MrOnak/avr_usbhid_gamepanel/board/board_commented.jpg

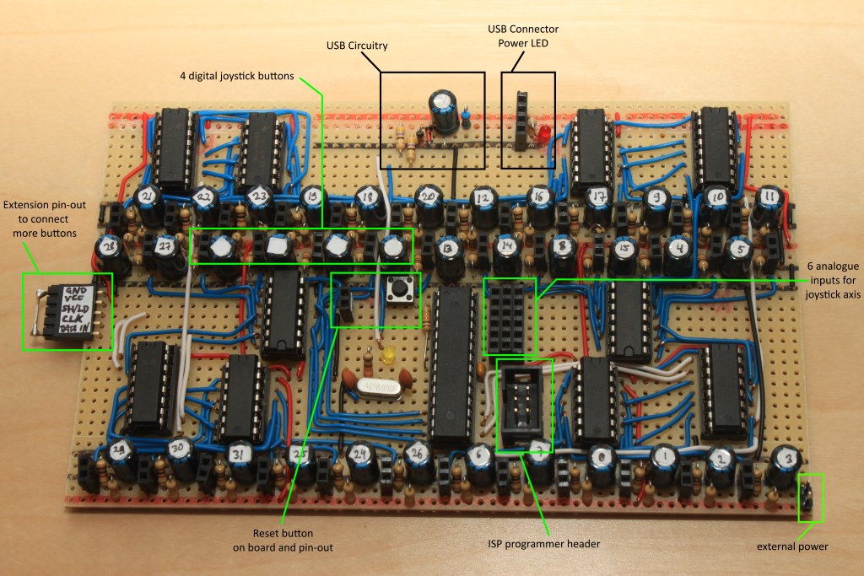
board/board_commented.jpg
