MrOnak/avr_usbhid_gamepanel/eagle/avr_gamepanel.png

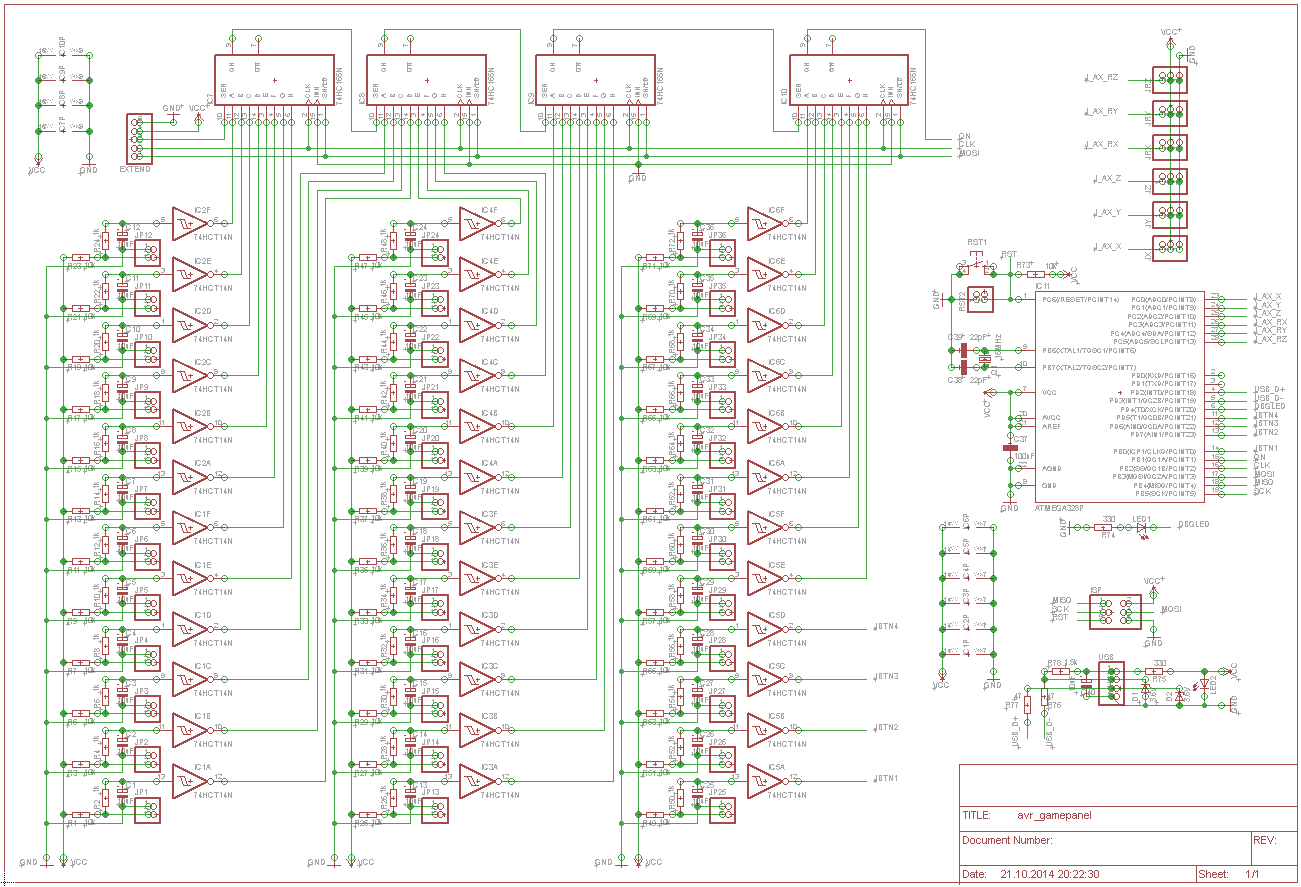
eagle/avr_gamepanel.png
