MrOnak/avr_usbhid_gamepanel/(threads)

Thread 2 (2016-04-25):

Additional usbSetInterrupt()

steinm, 2016-04-25:
While having problems with specifying a hid device consisting of a keyboard and a mouse I found your code and discovered the same problem I have. The device cannot be registered for some reason. You fixed it by adding
```
/**
 * no idea why I need to send this byte	but if I don't,
 * the OS won't register the device.
 */
 while (!usbInterruptIsReady()) {usbPoll();}
 usbSetInterrupt(0x00, 1);
```
That sends another 1 byte data packet and I really wonder why it solves your problem. It didn't help in my case. When I started to anaylse the usb signals I found out that the keyboard data was requested by the host, but was never send by the device. The reason is quite simple. A data packet may not have more than 8 Bytes in low speed operation, but the device tries to send 9 Bytes, because it also sends the report id. Reducing the keycode from 6 to 5 Bytes solved the problem.

hexagon5un, 2016-05-11:
Aha!  And that shouldn't really cause any problems most of the time either.  That's great.
