MrOnak/avr_usbhid_gamepanel/eagle/avr_gamepanel.sch

## EAGLE design eagle/avr_gamepanel.sch (2014-10-21)

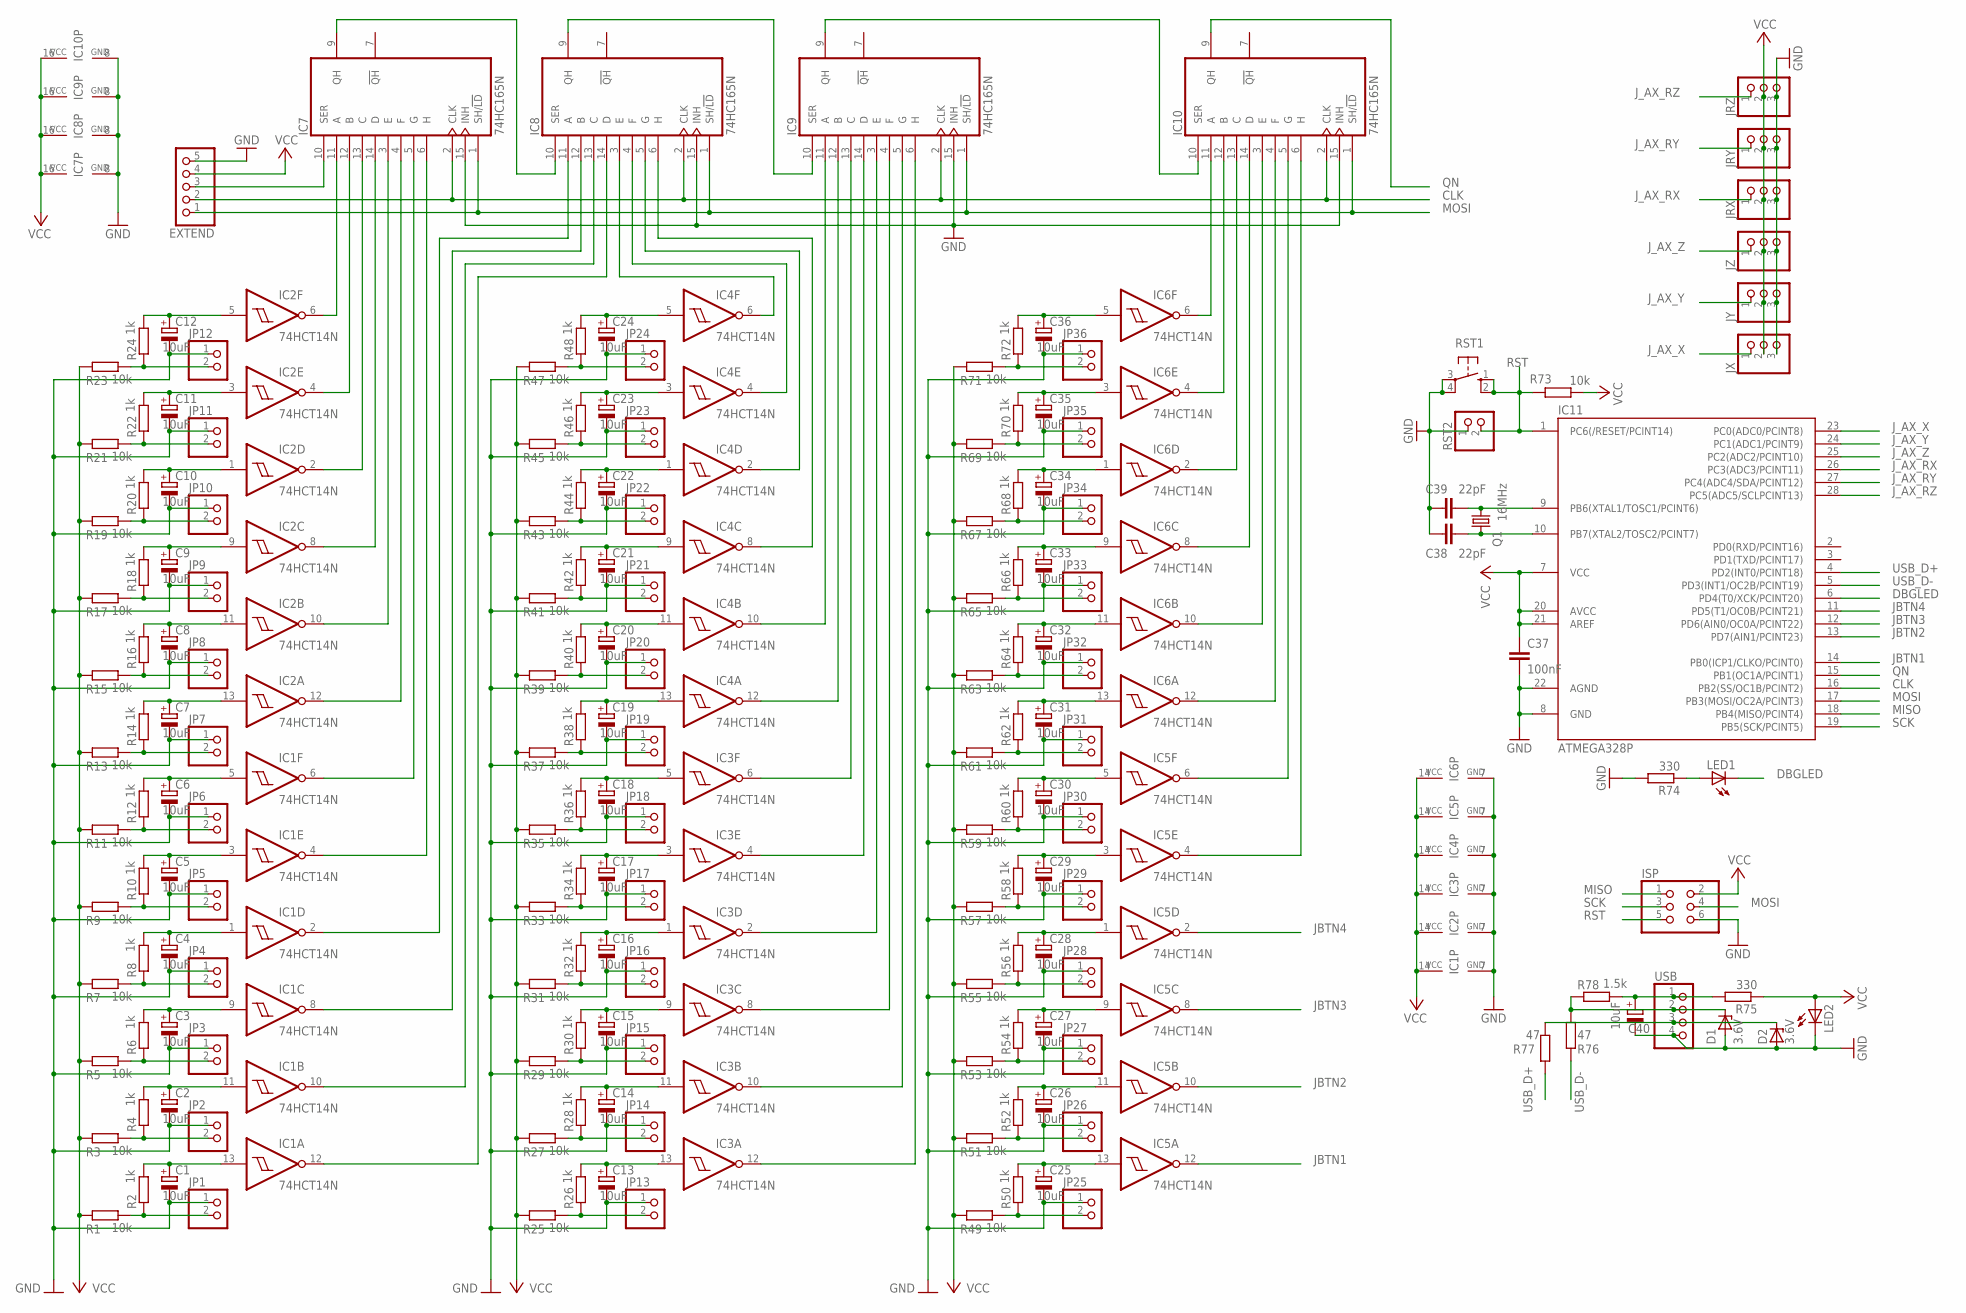
[picture p3: schematic avr_gamepanel.sch]

Parts:
C1, C2, C3, C4, C5, C6, C7, C8, C9, C10, C11, C12, C13, C14, C15, C16, C17, C18, C19, C20, C21, C22, C23, C24, C25, C26, C27, C28, C29, C30, C31, C32, C33, C34, C35, C36: 10uF; E2-5
C37: 100nF; C025-024X044
C38, C39: 22pF; C025-024X044
C40: 10uF; E2,5-6E
D1, D2: 3.6V; ZDIO-2.5
EXTEND: PINHD-1X5; 1X05
IC1, IC2, IC3, IC4, IC5, IC6: 74HCT14N; DIL14
IC7, IC8, IC9, IC10: 74HC165N; DIL16
IC11: ATMEGA328P; DIL28-3
ISP: PINHD-2X3; 2X03
JP1, JP2, JP3, JP4, JP5, JP6, JP7, JP8, JP9, JP10, JP11, JP12, JP13, JP14, JP15, JP16, JP17, JP18, JP19, JP20, JP21, JP22, JP23, JP24, JP25, JP26, JP27, JP28, JP29, JP30, JP31, JP32, JP33, JP34, JP35, JP36: PINHD-1X2; 1X02
JRX: PINHD-1X3; 1X03
JRY: PINHD-1X3; 1X03
JRZ: PINHD-1X3; 1X03
JX: PINHD-1X3; 1X03
JY: PINHD-1X3; 1X03
JZ: PINHD-1X3; 1X03
LED1, LED2: LEDLZR181; LZR181
Q1: 16MHz; HC49/S
R1, R3, R5, R7, R9, R11, R13, R15, R17, R19, R21, R23, R25, R27, R29, R31, R33, R35, R37, R39, R41, R43, R45, R47, R49, R51, R53, R55, R57, R59, R61, R63, R65, R67, R69, R71: 10k; 0204V
R2, R4, R6, R8, R10, R12, R14, R16, R18, R20, R22, R24, R26, R28, R30, R32, R34, R36, R38, R40, R42, R44, R46, R48, R50, R52, R54, R56, R58, R60, R62, R64, R66, R68, R70, R72: 1k; 0204/5
R73: 10k; 0204/7
R74, R75: 330; 0204/7
R76, R77: 47; 0204/7
R78: 1.5k; 0204/7
RST1: 10-XX; B3F-10XX
RST2: PINHD-1X2; 1X02
USB: PINHD-1X4; 1X04

Connections:
CLK: EXTEND.2, IC7.2 (CLK), IC8.2 (CLK), IC9.2 (CLK), IC10.2 (CLK), IC11.16 (PB2(SS/OC1B/PCINT2))
DBGLED: IC11.6 (PD4(T0/XCK/PCINT20)), LED1.K (C)
GND: C1.-, C2.-, C3.-, C4.-, C5.-, C6.-, C7.-, C8.-, C9.-, C10.-, C11.-, C12.-, C13.-, C14.-, C15.-, C16.-, C17.-, C18.-, C19.-, C20.-, C21.-, C22.-, C23.-, C24.-, C25.-, C26.-, C27.-, C28.-, C29.-, C30.-, C31.-, C32.-, C33.-, C34.-, C35.-, C36.-, C37.2, C38.1, C39.1, C40.-, D1.A, D2.A, EXTEND.5, IC1.7 (GND), IC2.7 (GND), IC3.7 (GND), IC4.7 (GND), IC5.7 (GND), IC6.7 (GND), IC7.8 (GND), IC7.15 (INH), IC8.8 (GND), IC8.15 (INH), IC9.8 (GND), IC9.15 (INH), IC10.8 (GND), IC10.15 (INH), IC11.8 (GND), IC11.22 (AGND), ISP.6, JP1.1, JP2.1, JP3.1, JP4.1, JP5.1, JP6.1, JP7.1, JP8.1, JP9.1, JP10.1, JP11.1, JP12.1, JP13.1, JP14.1, JP15.1, JP16.1, JP17.1, JP18.1, JP19.1, JP20.1, JP21.1, JP22.1, JP23.1, JP24.1, JP25.1, JP26.1, JP27.1, JP28.1, JP29.1, JP30.1, JP31.1, JP32.1, JP33.1, JP34.1, JP35.1, JP36.1, JRX.3, JRY.3, JRZ.3, JX.3, JY.3, JZ.3, LED2.K (C), R74.2, RST1.3, RST1.4 (P1), RST2.1, USB.4
JBTN1: IC5.12 (O), IC11.14 (PB0(ICP1/CLKO/PCINT0))
JBTN2: IC5.10 (O), IC11.13 (PD7(AIN1/PCINT23))
JBTN3: IC5.8 (O), IC11.12 (PD6(AIN0/OC0A/PCINT22))
JBTN4: IC5.2 (O), IC11.11 (PD5(T1/OC0B/PCINT21))
J_AX_RX: IC11.26 (PC3(ADC3/PCINT11)), JRX.1
J_AX_RY: IC11.27 (PC4(ADC4/SDA/PCINT12)), JRY.1
J_AX_RZ: IC11.28 (PC5(ADC5/SCLPCINT13)), JRZ.1
J_AX_X: IC11.23 (PC0(ADC0/PCINT8)), JX.1
J_AX_Y: IC11.24 (PC1(ADC1/PCINT9)), JY.1
J_AX_Z: IC11.25 (PC2(ADC2/PCINT10)), JZ.1
MISO: IC11.18 (PB4(MISO/PCINT4)), ISP.1
MOSI: EXTEND.1, IC7.1 (SH/!LD), IC8.1 (SH/!LD), IC9.1 (SH/!LD), IC10.1 (SH/!LD), IC11.17 (PB3(MOSI/OC2A/PCINT3)), ISP.4
unnamed: JP1.2, R1.2, R2.1
unnamed: JP9.2, R17.2, R18.1
unnamed: C1.+, IC1.13 (I), R2.2
unnamed: JP2.2, R3.2, R4.1
unnamed: C9.+, IC2.9 (I), R18.2
unnamed: C2.+, IC1.11 (I), R4.2
unnamed: JP3.2, R5.2, R6.1
unnamed: JP10.2, R19.2, R20.1
unnamed: C3.+, IC1.9 (I), R6.2
unnamed: JP4.2, R7.2, R8.1
unnamed: C10.+, IC2.1 (I), R20.2
unnamed: C4.+, IC1.1 (I), R8.2
unnamed: JP5.2, R9.2, R10.1
unnamed: JP11.2, R21.2, R22.1
unnamed: C5.+, IC1.3 (I), R10.2
unnamed: JP6.2, R11.2, R12.1
unnamed: C11.+, IC2.3 (I), R22.2
unnamed: C6.+, IC1.5 (I), R12.2
unnamed: JP7.2, R13.2, R14.1
unnamed: JP12.2, R23.2, R24.1
unnamed: C7.+, IC2.13 (I), R14.2
unnamed: JP8.2, R15.2, R16.1
unnamed: C12.+, IC2.5 (I), R24.2
unnamed: C8.+, IC2.11 (I), R16.2
unnamed: JP13.2, R25.2, R26.1
unnamed: C13.+, IC3.13 (I), R26.2
unnamed: JP14.2, R27.2, R28.1
unnamed: C14.+, IC3.11 (I), R28.2
unnamed: JP15.2, R29.2, R30.1
unnamed: C15.+, IC3.9 (I), R30.2
unnamed: JP16.2, R31.2, R32.1
unnamed: C16.+, IC3.1 (I), R32.2
unnamed: JP17.2, R33.2, R34.1
unnamed: C17.+, IC3.3 (I), R34.2
unnamed: JP18.2, R35.2, R36.1
unnamed: C18.+, IC3.5 (I), R36.2
unnamed: JP19.2, R37.2, R38.1
unnamed: C19.+, IC4.13 (I), R38.2
unnamed: JP20.2, R39.2, R40.1
unnamed: C20.+, IC4.11 (I), R40.2
unnamed: JP21.2, R41.2, R42.1
unnamed: C21.+, IC4.9 (I), R42.2
unnamed: JP22.2, R43.2, R44.1
unnamed: C22.+, IC4.1 (I), R44.2
unnamed: JP23.2, R45.2, R46.1
unnamed: C23.+, IC4.3 (I), R46.2
unnamed: JP24.2, R47.2, R48.1
unnamed: C24.+, IC4.5 (I), R48.2
unnamed: JP25.2, R49.2, R50.1
unnamed: C25.+, IC5.13 (I), R50.2
unnamed: JP26.2, R51.2, R52.1
unnamed: C26.+, IC5.11 (I), R52.2
unnamed: JP27.2, R53.2, R54.1
unnamed: C27.+, IC5.9 (I), R54.2
unnamed: JP28.2, R55.2, R56.1
unnamed: C28.+, IC5.1 (I), R56.2
unnamed: JP29.2, R57.2, R58.1
unnamed: C29.+, IC5.3 (I), R58.2
unnamed: JP30.2, R59.2, R60.1
unnamed: C30.+, IC5.5 (I), R60.2
unnamed: JP31.2, R61.2, R62.1
unnamed: C31.+, IC6.13 (I), R62.2
unnamed: JP32.2, R63.2, R64.1
unnamed: C32.+, IC6.11 (I), R64.2
unnamed: JP33.2, R65.2, R66.1
unnamed: C33.+, IC6.9 (I), R66.2
unnamed: JP34.2, R67.2, R68.1
unnamed: C34.+, IC6.1 (I), R68.2
unnamed: JP35.2, R69.2, R70.1
unnamed: C35.+, IC6.3 (I), R70.2
unnamed: JP36.2, R71.2, R72.1
unnamed: C36.+, IC6.5 (I), R72.2
unnamed: IC2.6 (O), IC7.11 (A)
unnamed: IC2.4 (O), IC7.12 (B)
unnamed: IC2.2 (O), IC7.13 (C)
unnamed: IC2.8 (O), IC7.14 (D)
unnamed: IC2.10 (O), IC7.3 (E)
unnamed: IC2.12 (O), IC7.4 (F)
unnamed: IC1.6 (O), IC7.5 (G)
unnamed: IC1.4 (O), IC7.6 (H)
unnamed: IC1.2 (O), IC8.11 (A)
unnamed: IC1.8 (O), IC8.12 (B)
unnamed: IC1.10 (O), IC8.13 (C)
unnamed: IC1.12 (O), IC8.14 (D)
unnamed: IC4.6 (O), IC8.3 (E)
unnamed: IC4.4 (O), IC8.4 (F)
unnamed: IC4.2 (O), IC8.5 (G)
unnamed: IC4.8 (O), IC8.6 (H)
unnamed: IC4.10 (O), IC9.11 (A)
unnamed: IC4.12 (O), IC9.12 (B)
unnamed: IC3.6 (O), IC9.13 (C)
unnamed: IC3.4 (O), IC9.14 (D)
unnamed: IC3.2 (O), IC9.3 (E)
unnamed: IC3.8 (O), IC9.4 (F)
unnamed: IC3.10 (O), IC9.5 (G)
unnamed: IC3.12 (O), IC9.6 (H)
unnamed: IC6.6 (O), IC10.11 (A)
unnamed: IC6.4 (O), IC10.12 (B)
unnamed: IC6.2 (O), IC10.13 (C)
unnamed: IC6.8 (O), IC10.14 (D)
unnamed: IC6.10 (O), IC10.3 (E)
unnamed: IC6.12 (O), IC10.4 (F)
unnamed: IC5.6 (O), IC10.5 (G)
unnamed: IC5.4 (O), IC10.6 (H)
unnamed: IC7.9 (QH), IC8.10 (SER)
unnamed: IC8.9 (QH), IC9.10 (SER)
unnamed: IC9.9 (QH), IC10.10 (SER)
unnamed: EXTEND.3, IC7.10 (SER)
unnamed: C40.+, R75.2, R78.2, USB.1
unnamed: LED1.A, R74.1
unnamed: C38.2, IC11.10 (PB7(XTAL2/TOSC2/PCINT7)), Q1.1
unnamed: C39.2, IC11.9 (PB6(XTAL1/TOSC1/PCINT6)), Q1.2
unnamed: D1.C, R76.1, R78.1, USB.2
unnamed: D2.C, R77.1, USB.3
QN: IC10.9 (QH), IC11.15 (PB1(OC1A/PCINT1))
RST: IC11.1 (PC6(/RESET/PCINT14)), ISP.5, R73.2, RST1.1 (S), RST1.2 (S1), RST2.2
SCK: IC11.19 (PB5(SCK/PCINT5)), ISP.3
USB_D+: IC11.4 (PD2(INT0/PCINT18)), R77.2
USB_D-: IC11.5 (PD3(INT1/OC2B/PCINT19)), R76.2
VCC: C37.1, EXTEND.4, IC1.14 (VCC), IC2.14 (VCC), IC3.14 (VCC), IC4.14 (VCC), IC5.14 (VCC), IC6.14 (VCC), IC7.16 (VCC), IC8.16 (VCC), IC9.16 (VCC), IC10.16 (VCC), IC11.7 (VCC), IC11.20 (AVCC), IC11.21 (AREF), ISP.2, JRX.2, JRY.2, JRZ.2, JX.2, JY.2, JZ.2, LED2.A, R1.1, R3.1, R5.1, R7.1, R9.1, R11.1, R13.1, R15.1, R17.1, R19.1, R21.1, R23.1, R25.1, R27.1, R29.1, R31.1, R33.1, R35.1, R37.1, R39.1, R41.1, R43.1, R45.1, R47.1, R49.1, R51.1, R53.1, R55.1, R57.1, R59.1, R61.1, R63.1, R65.1, R67.1, R69.1, R71.1, R73.1, R75.1
