MrOnak/avr_usbhid_gamepanel/gamejoystick.h

// defines for the joystick
// defines for the analog inputs
#define REGISTER_ANALOG		DDRC
#define PORT_ANALOG			PORTC
#define PORT_IN_ANALOG		PINC

#define PIN_ANALOG_X		PC0
#define PIN_ANALOG_Y		PC1
#define PIN_ANALOG_Z		PC2
#define PIN_ANALOG_RX		PC3
#define PIN_ANALOG_RY		PC4
#define PIN_ANALOG_RZ		PC5

// joystick has 4 buttons
#define NUMBER_OF_BUTTONS 4

// config for the digital buttons
#define REGISTER_JBUTTON_1	DDRB
#define PORT_JBUTTON_1		PORTB
#define PORT_IN_JBUTTON_1	PINB
#define PIN_JBUTTON_1 		PB0

#define REGISTER_JBUTTON_2	DDRD
#define PORT_JBUTTON_2		PORTD
#define PORT_IN_JBUTTON_2	PIND
#define PIN_JBUTTON_2 		PD7

#define REGISTER_JBUTTON_3	DDRD
#define PORT_JBUTTON_3		PORTD
#define PORT_IN_JBUTTON_3	PIND
#define PIN_JBUTTON_3 		PD6

#define REGISTER_JBUTTON_4	DDRD
#define PORT_JBUTTON_4		PORTD
#define PORT_IN_JBUTTON_4	PIND
#define PIN_JBUTTON_4 		PD5
