MrOnak/avr_usbhid_gamepanel/(commit log)

2014-09-19 Initial release
    [avr_gamepanel.sch]
2014-09-19 added sample board with comments
2014-10-21 fixed two minor circuitry errors
    [avr_gamepanel.sch]
2014-11-14 fixed 2 layout bugs
    - missing GND terminal
    - ISP was mirrored
